Knallee/etf_blinky/hardware/Manufacturing/Bill of Materials-make_etf_great_again.xlsx

Designator | Quantity | Value | JLCPCB Part # | Mount
BTN1, BTN2, C21, MK1, P2, P3, PWR, R24, U5 | 9 | Button, NC, [NoParam], 2x3 Pin Header, 2.54mm, 1x2 Pin Header, 595-LM358P |  | No
C1, C2 | 2 | 1u | C1848 | Yes
C3, C4, C5, C6, C7, C8, C9, C10, C11, C12 | 10 | 100n | C24497 | Yes
C13, C14, C17, C18, C27 | 5 | 1u | C77386 | Yes
C15, C16 | 2 | 10u | C342827 | Yes
C19, C20, C23 | 3 | 10u | C386081 | Yes
C22 | 1 | 1n | C100040 | Yes
C24, C25, C26 | 3 | 100n | C14663 | Yes
D1, D2, D3, D4, D5, D6, D7, D8, D9, D10 | 10 |  | C2829089 | Yes
D11, D12, D14 | 3 |  | C117941 | Yes
L1 | 1 | 1u | C19947630 | No
LED1, LED2, LED3 | 3 | 0805 LED | C2295 | Yes
R1, R2, R5, R9, R18, R19, R20 | 7 | 1k | C21190 | Yes
R3, R4, R7, R10, R11, R16, R25, R26 | 8 | 10k | C98220 | Yes
R6 | 1 | 768k | C2933258 | Yes
R8, R14 | 2 | 100k | C14675 | Yes
R12 | 1 | 20k | C723637 | Yes
R13 | 1 | 5k6 | C138278 | Yes
R15 | 1 | 120R | C114681 | Yes
R17 | 1 | 56k | C114630 | Yes
R21, R22, R23 | 3 | 0R | C95177 | Yes
U2 | 1 |  | C919459 | Yes
U3, U4 | 2 |  | C2873627 | Yes
U6 | 1 |  | C2325 | Yes
