Knallee/etf_blinky/(threads)

Thread 1 (2024-06-15):

Shutdown task

Noxet, 2024-06-15:
- When PWR button is pressed during normal operation, schedule shutdown animation immediately.
- Shutdown animation shal light all LEDs and turn off one by one, as long as the button remains pressed
- If button is released during animation, we cancel the shutdown procedure
- When button is released, then turn off power

Closed 2024-09-16.

Thread 3 (2024-07-02):

PWR button can't shut down MCU properly

Noxet, 2024-07-02:
- When red LEDs are on, pressing the PWER button causes the MCU to shutdown seemingly properly, and theres is 0V on PWR button pin towards MCU.
- WHen blue/green LEDs are on, pressing PWR button causes the MCU to "restart" back to red LEDs, but the voltage on PWR button is 0.5V

Thread 4 (2024-07-07):

Swap EN and VIN on VREGs

Noxet, 2024-07-07:
Pin 1 and 3 shall be swapped for the LDO VREGs.

Thread 5 (2024-07-07):

LED 2 probably damaged

Noxet, 2024-07-07:
LED 2 might have been damaged from the high-speed programming (-B 1)

Thread 12 (2024-09-25):

Replace bb_spi with USI

Noxet, 2024-09-25:
Today, we bit-bang the SPI protocol, and it works properly.
However, let's get the USI working to offload the CPU and minimize latency since we turn off interrupts during transmission

Thread 13 (2024-09-28):

Implement FSM to handle complex logic

Noxet, 2024-09-28:
Due to more features being added where buttons have multiple purposes, we need an FSM to manage the states.
We want to handle:
- User switching states by pressing single buttons normally
- Increase/decrease intensity by holding one button and pressing the other
- Show battery status by quickly pressing both buttons

Closed 2024-09-29.

Thread 18 (2024-10-01):

Finish battery level indicator

Noxet, 2024-10-01:
Calculate reasonable lower and upper limits on the battery voltage level and display it nicely.
Note that the batteries can be higher voltage than MCU VDD, but we also divide the battery level by 2 in the resistor divider.

Closed 2024-10-01.

Thread 19 (2024-12-14):

Fix battery level check

Noxet, 2024-12-14:
- Add event to check battery every 5 minutes
- Make the battery level bar correct
