Knallee/etf_blinky/hardware/Documentation/Schematic Prints.PDF

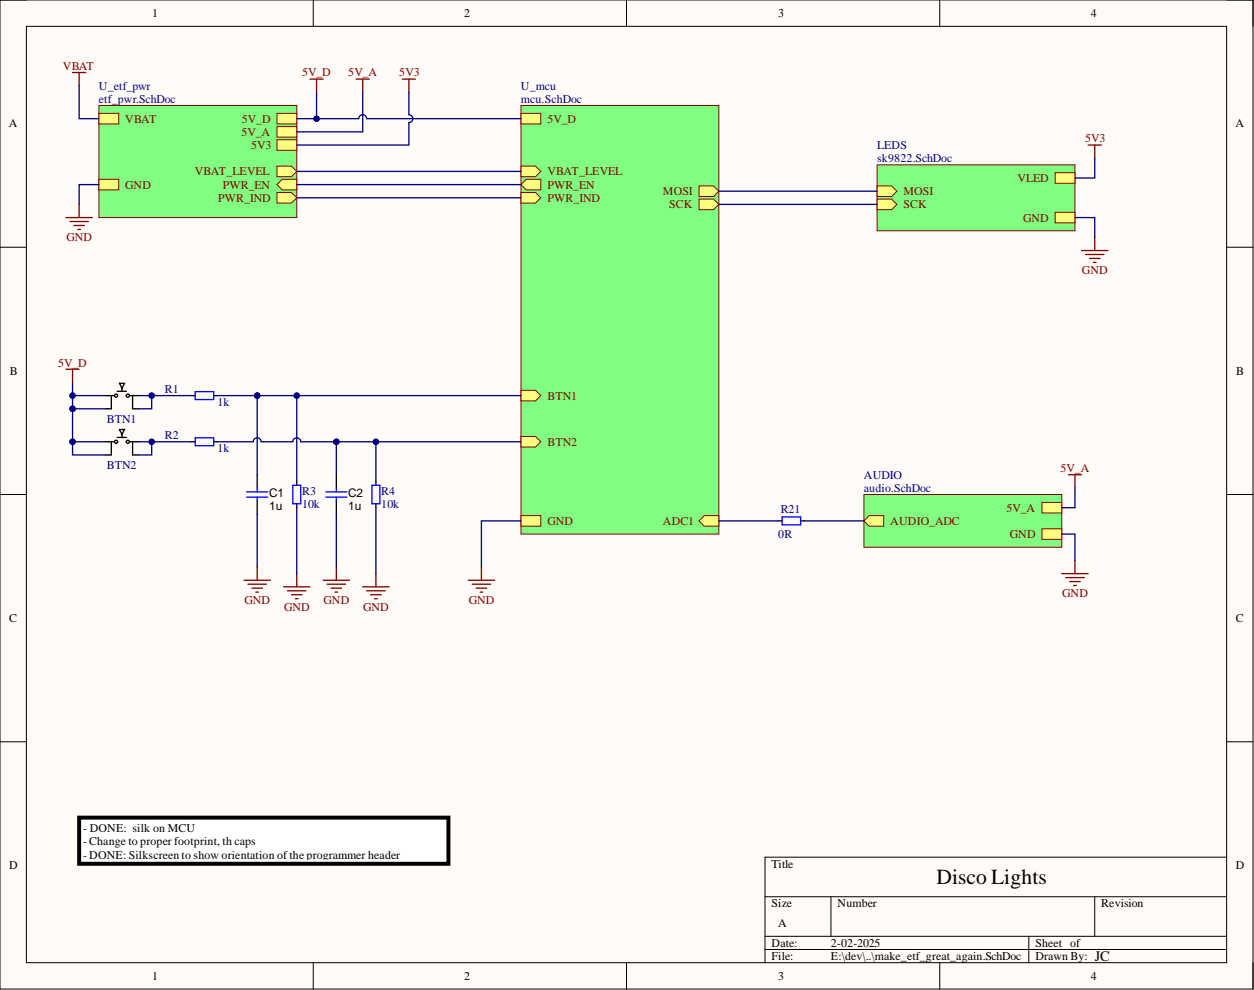
[picture p3: page 1]

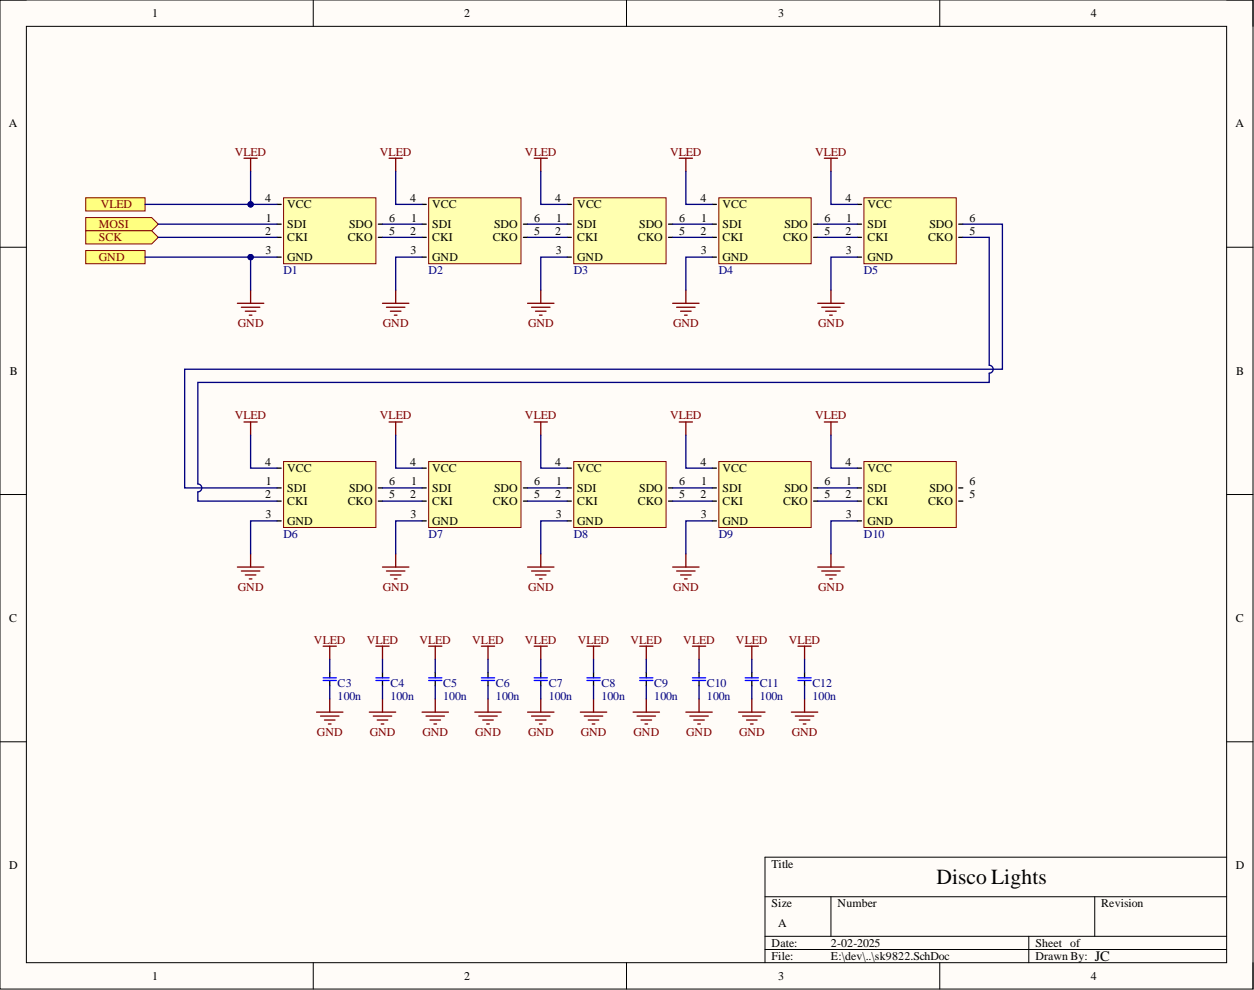
[picture p4: page 2]

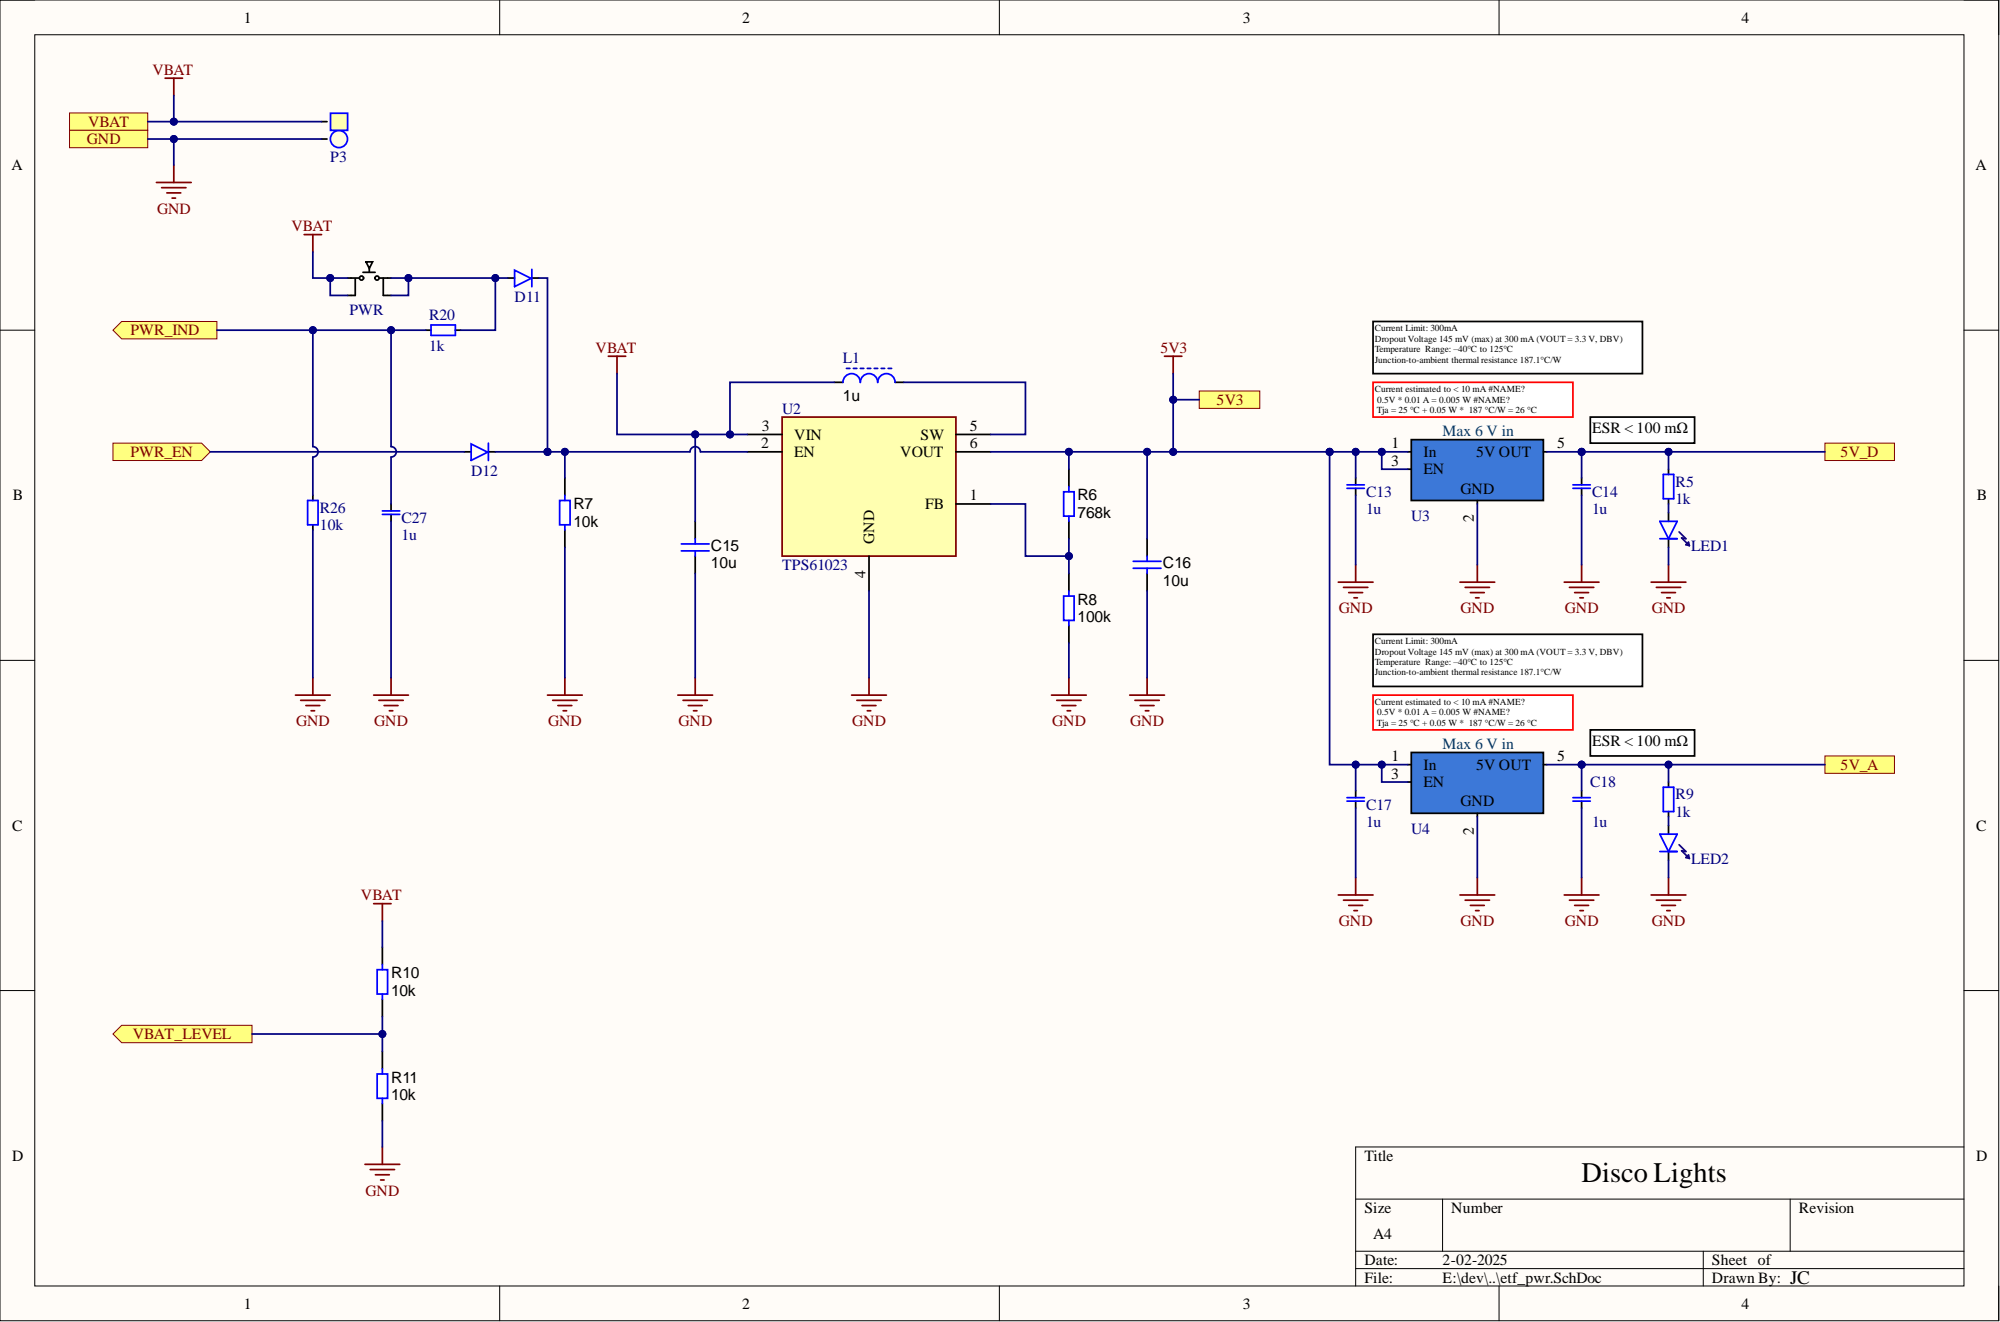
[picture p5: page 3]

Current Limit: 300mA
Dropout Voltage 145 mV (max) at 300 mA (VOUT = 3.3 V, DBV)
Temperature Range: –40°C to 125°C
Junction-to-ambient thermal resistance 187.1°C/W

Current estimated to < 10 mA #NAME?
0.5V * 0.01 A = 0.005 W #NAME?
Tja = 25 °C + 0.05 W * 187 °C/W = 26 °C

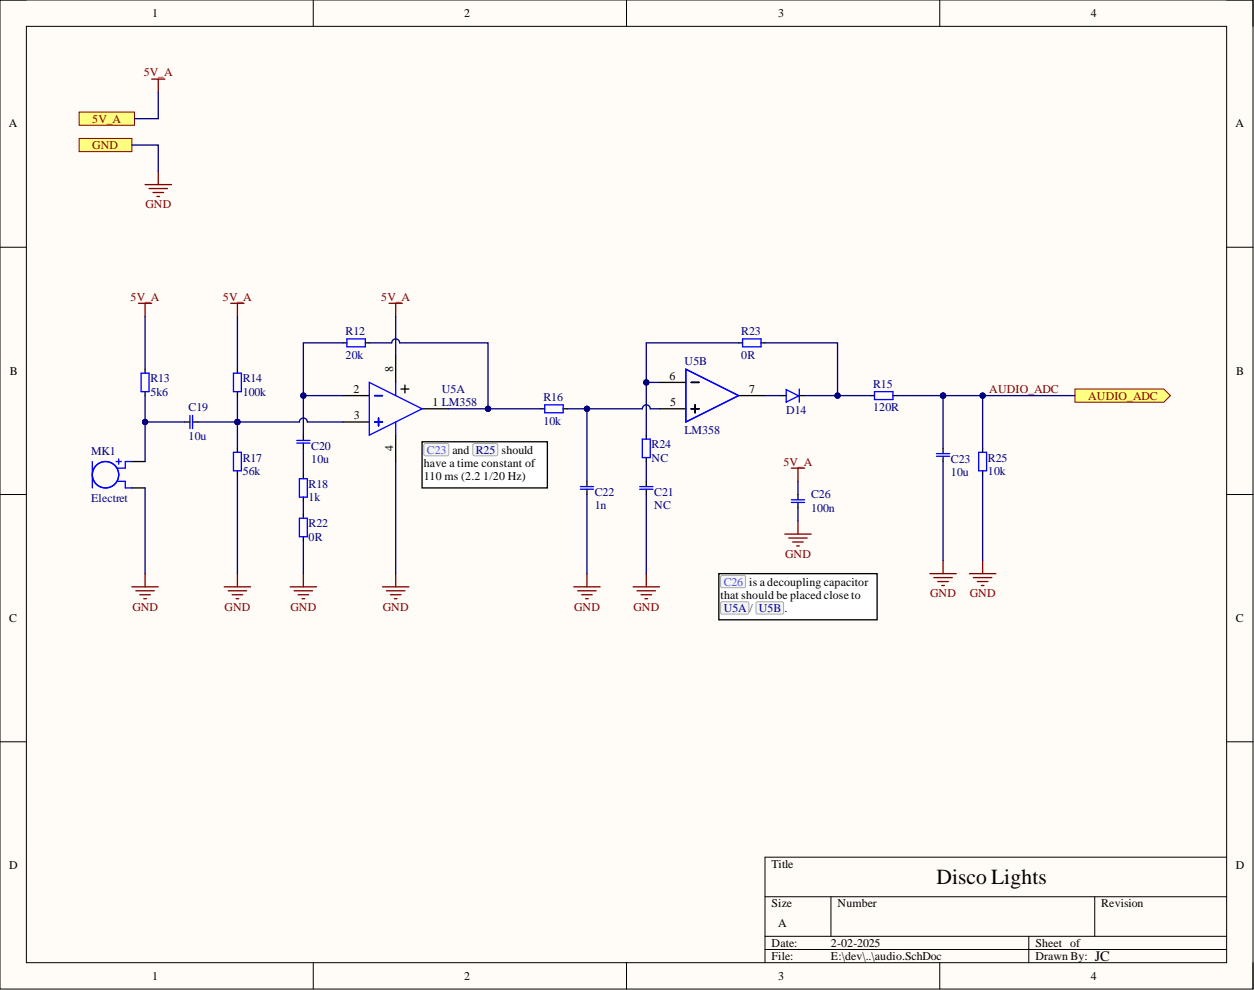
[picture p6: page 4]

C23 and R25 should
have a time constant of

C26 is a decoupling capacitor
that should be placed close to

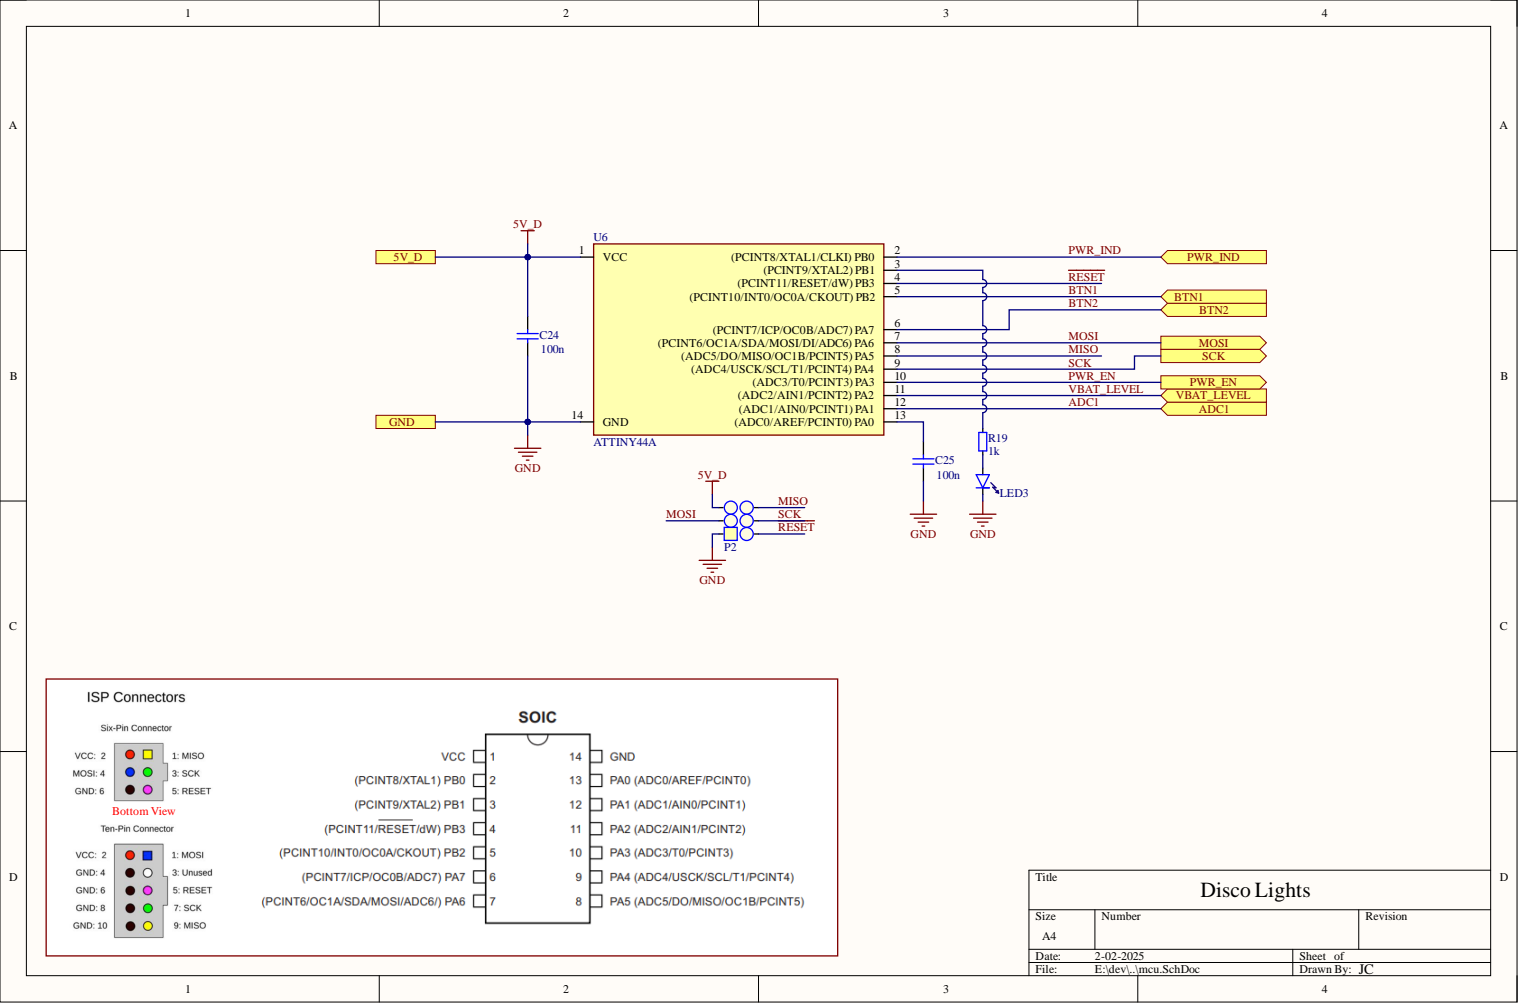
[picture p7: page 5]
