Knallee/etf_blinky/hardware/Documentation/PCB.PDF

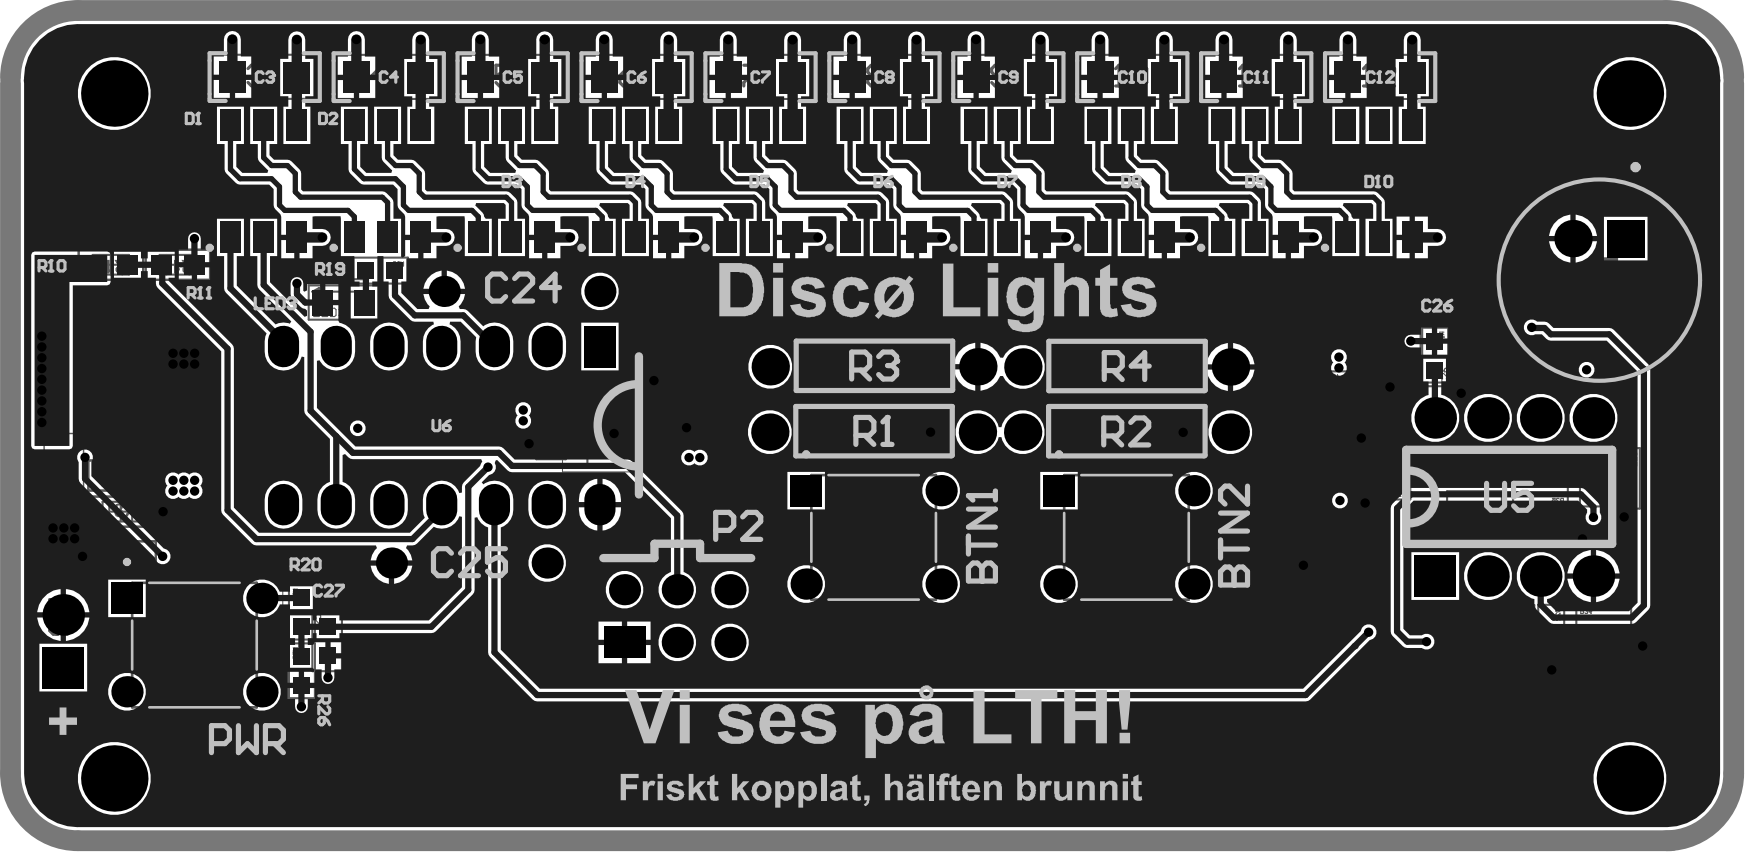
[picture p8: page 1]

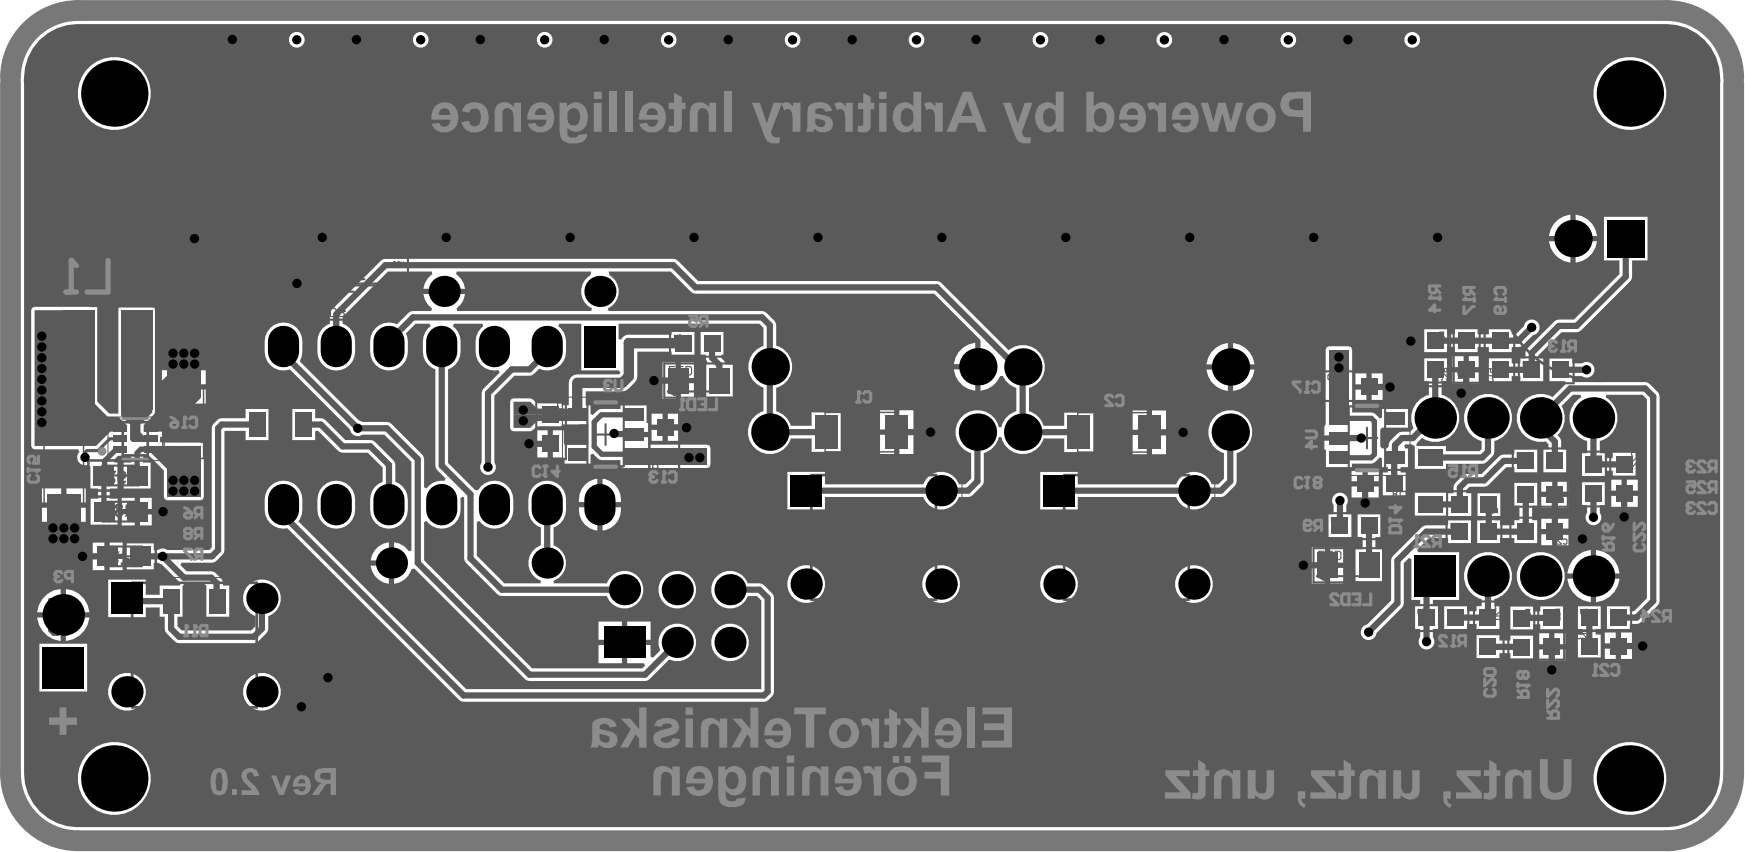
[picture p9: page 2]
