Knallee/etf_blinky/(commit log)

2023-09-07 my fuck up
    [auido.SchDoc, etf_blink.PcbDoc, mcu.SchDoc]
2024-05-04 Basic led test works
2024-12-22 Updated JLC part numbers and added new silkscreen text.
    [Bill of Materials-make_etf_great_again.xlsx, bom_make_etf_great_again.xlsx, etf_blink.PcbDoc, etf_pwr.SchDoc, make_etf_great_again.SchDoc, mcu.SchDoc]
2024-12-22 Generated new gerber files.
    [Bill of Materials-make_etf_great_again.xlsx, Pick Place for etf_blink.csv, bom_make_etf_great_again.xlsx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]
2025-02-02 Added schematic and PCB pdfs
2025-02-02 Updated job, added schematic and pcb pdf
2025-08-03 Updated colors to make print better
2025-12-15 Replaced TH components with SMD
    [etf_blink.PcbDoc, make_etf_great_again.PrjPcb, make_etf_great_again.SchDoc, mcu.SchDoc]
2026-01-16 Fixed some wrong part numbers, and ordered 125 PCBs, bump version
    [Bill of Materials-make_etf_great_again.xlsx, Pick Place for etf_blink.csv, audio.SchDoc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]
2026-01-19 Removed old drill file
